TohidBeh/Health-Monitoring-System/Project Description Report/HMS_Report.pdf

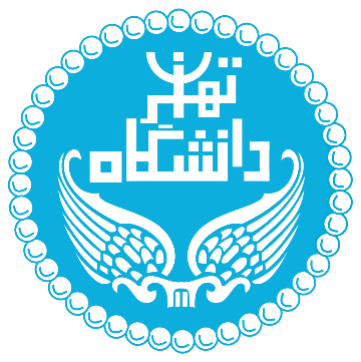
[picture p3: figure]
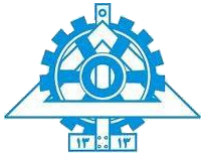
[picture p4: figure]

### به نام خدا

دانشگاه تهران

پردیس دانشکدگان فنی

دانشکده مهندسی برق و کامپیوتر

## ________گزارش پروژه کارشناسی_______

پایاننامه براي دریافت درجه کارشناسی
در رشته مهندسی برق گرایش بایوالکتریک

طراحی و پیادهسازی سامانه پوش یدنی IoT برای مانیتورینگ بالدرنگ عالئم حیاتی و تحلیل هوشمند دادهها

توحید بهشتی__810100100
استاد راهنما : دکتر سیدکمال الدین ستاره دان

نیمسال اول 1405_1404

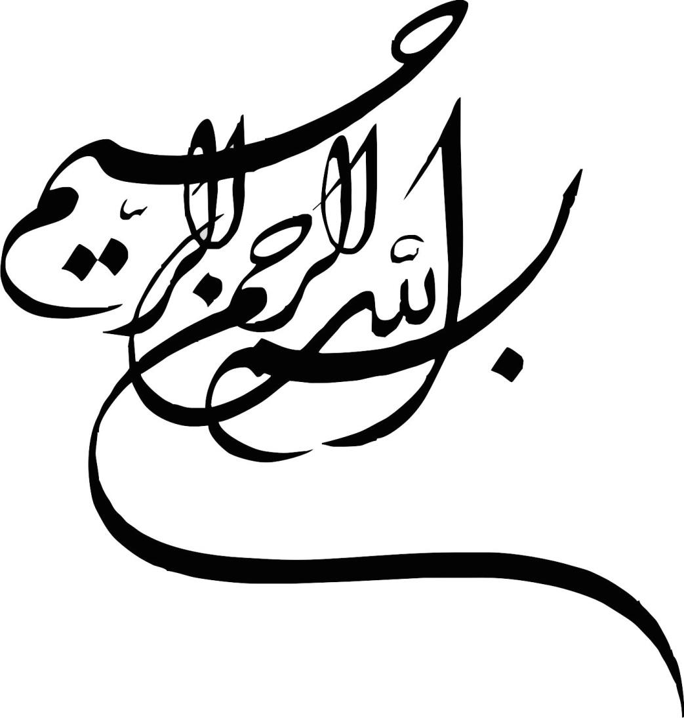
[picture p5: figure]

تعهدنامه اصالت اثر
باسمه تعالی

اینجانب توحید بهشتی تائید می کنم که مطالب مندرج در این پایان نامه حاصل تالش اینجانب است و
به دستاوردهاي پژوهشی دیگران که در این نوشته از آنها استفاده شده است مطابق مقررات ارجاع گردیده است. این پایان نامه قبالٌ براي احراز هیچ مدرك هم سطح یا باالتر ارائه نشده است. کلیه حقوق مادي و معنوي این اثر متعلق به دانشکده فنی دانشگاه تهران می باشد.

نام و نام خانوادگی دانشجو : توحید بهشتی

امضاي دانشجو :

## چکیده

با توجه به افزایش نیاز به پایش مداوم وضعیت سالمت افراد، به ویژه در بیماران قلبی و تنفسی، توسعه سامانههاي هوشمند و کم هزینه براي مانیتورینگ عالئم حیاتی اهمیت زیادي پیدا کرده است. در این پروژه، یک سامانه پایش سالمت ) system monitoring Health )مبتنی بر اینترنت اشیاء)IOT )طراحی و پیادهسازي شد که قادر است برخی از عالئم حیاتی مهم شامل ضربان قلب(BPM (، سطح اکسیژن خون (₂SpO(، دماي بدن و همچنین دماي و رطوبت محیط بیمار را به صورت بالدرنگ اندازهگیري و نمایش دهد .

در این سامانه از میکروکنترلر 32ESP به عنوان هسته اصلی پردازش و ارتباط بی سیم استفاده شده است. سنسور 30100MAX براي اندازهگیري ضربان قلب و میزان اکسیژن خون، سنسور 20B18DS براي دماي بدن و سنسور 11DHT براي اندازه گیري شرایط محیطی)در واقع دما و رطوبت اتاق( به کار گرفته شدند. داده هاي دریافتی پس از پردازش اولیه در میکروکنترلر، از طریق شبکه Fi-Wi در قالب یک وب سرور تعبیه شده (Server Web Embedded (در اختیار کاربر قرار می گیرند و به صورت لحظه اي در یک داشبورد تحت وب قابل مشاهده هست .

در فرآیند پیاده سازي، چالش هاي بسیاري از جمله ناپایداري ارتباطC2I ، خطاي خواندن دماي سنسور 20B18DS و وابستگی عملکرد سنسور 30100MAX به ساختار حلقه اصلی برنامه و مشکالت اختالف نرخ ارسال داده توسط هرکدام از سنسورها, شناسایی و برطرف شد. در نهایت، سامانه توسعه یافته توانست داده هاي حیاتی را با پایداري مناسب دریافت و به صورت برخط نمایش دهد. این پروژه نمونه اي از یک سیستم پایش سالمت کم هزینه و قابل توسعه است که می تواند مبنایی براي گسترش به سامانه هاي ابري، ذخیره سازي بلندمدت داده ها و تحلیل هوشمند عالئم حیاتی در آینده باشد .

کلمات کلیدی : اینترنت اشیاء(IoT (، پایش سالمت، 32ESP، 30100MAX، سیستم غیرمسدودکننده، وبسرور داخلی، تشخیص ناهنجاري

فهرست
چکیده 4 |
فصل اول :مقدمه و بیان مساله7 |

## فصل اول : مقدمه و بیان مساله

-1-1 مقدمه
در دهه هاي اخیر، پیشرفت همزمان فناوري هاي دیجیتال، سیستمهاي نهفته و ارتباطات بیسیم، زمینه را براي به وجود امدن نسل جدید از سامانه هاي هوشمند فراهم کرده است که قادرند داده هاي محیطی و زیستی را به صورت پیوسته جمعآوري، پردازش و منتقل کنند. در این میان، حوزه پایش سالمت مبتنی بر اینترنت اشیا (Monitoring Health Based-IoT (به دلیل ارتباط مستقیم با کیفیت زندگی انسان، از اهمیت ویژه اي برخوردار شده است. افزایش امید به زندگی، شیوع بیماري هاي مزمن قلبی و تنفسی، و نیاز به نظارت مستمر بر وضعیت بیماران، ضرورت توسعه سامانههاي پایش بالدرنگ و کم هزینه را بیش از پیش نمایان ساخته است.

در طول دوران تحصیل در گرایش بایوالکتریک، همواره عالقه مند بودم مفاهیم تئوري و اکادمیک مانند پردازش سیگنالهاي زیستی، طراحی مدارهاي الکتریکی و سیستم هاي نهفته را در قالب یک سیستم واقعی و کاربردي پیاده سازي کنم. به همین دلیل در این پروژه تالش کردم یک سیستم پایش سالمت بر پایه اینترنت اشیا طراحی کنم که هم از نظر سختافزاري و هم از نظر نرم افزاري به صورت کامل توسط خودم توسعه داذ ه شود و در عین حال مقرون به صرفه و قابل توسعه بیشتر باشد .

پایش مستمر عالئم حیاتی نظیر ضربان قلب، سطح اکسیژن خون و دماي بدن، نه تنها در محیط هاي بیمارستانی بلکه در کاربردهاي خانگی و مراقبت از راه دور نیز اهمیت دارد. با این حال، بسیاري از سامانههاي موجود یا داراي هزینه باال هستند یا به زیرساختهاي پیچیده ابري وابستگی کامل دارند. از سوي دیگر، پیاده سازي عملی چنین سیستم هایی با چالشهاي متعددي در سطح سختافزار و نرم افزار همراه است؛ چالش هایی که در بسیاري از مطالعات صرفاً به صورت تئوریک مطرح شده و کمتر در قالب یک تجربه مهندسی کامل مورد بررسی قرار گرفته اند .

پروژه حاضر با هدف طراحی و پیاده سازي یک سامانه پوشیدنی مبتنی بر 32ESP براي پایش بالدرنگ عالئم حیاتی شکل گرفته است؛ سامانه اي که عالوه بر اندازه گیري پارامترهاي زیستی، بر پایداري معماري نرم افزاري، مدیریت زمان بندي سنسورها، حذف نویز و ارائه بازخورد هوشمند در صورت بروز ناهنجاري تمرکز دارد. در این تحقیق تالش شده است که مفاهیم تئوریک سیستم هاي نهفته، پردازش سیگنالهاي زیستی و اینترنت اشیاء در قالب یک سامانه عملی، کم هزینه و قابل توسعه تجمیع شوند .

-1-2تاریخچه ای از موضوع تحقیق

پایش عالئم حیاتی سابقه اي طوالنی در پزشکی دارد. از دستگاههاي الکتروکاردیوگراف (ECG (در دهه هاي ابتدایی قرن بیستم گرفته تا مانیتورهاي چندپارامتري بیمارستانی، همواره هدف، ثبت دقیق سیگنالهاي زیستی براي تشخیص و پایش وضعیت بیمار بوده است. با ورود میکروکنترلرها و سیستم هاي دیجیتال در دهه هاي اخیر، امکان کوچک سازي تجهیزات و انتقال داده ها بهصورت الکترونیکی فراهم شد .

ظهور فناوري اینترنت اشیاء نقطه عطفی در این مسیر محسوب می شود IoT .امکان اتصال اشیاء فیزیکی به شبکه را فراهم می سازد و این قابلیت باعث شد مفهوم ”پایش از راه دور“ از یک ایده تحقیقاتی به یک راهکار عملی تبدیل شود. در بسیاري از مطالعات دانشگاهی، ساختار کلی سیستم شامل یک سنسور زیستی، یک میکروکنترلر مجهز به ماژول ارتباطی و یک پلتفرم ابري براي ذخیره سازي و تحلیل داده ها معرفی شده است.

با وجود پیشرفت هاي چشمگیر، بررسی دقیق تر این حوزه نشان می دهد که تمرکز بسیاري از پروژه ها بر ارسال داده به فضاي ابري بوده و کمتر به چالش هاي عملی نظیر ناپایداري ارتباط C2I ، تأثیر ساختار حلقه برنامه بر کیفیت داده هاي سنسورPPG ، یا تداخل زمانی میان Fi-Wi و نمونه برداري سنسورها پرداخته شده است. همچنین بسیاري از سامانه هاي تجاري موجود اگرچه از نظر عملکرد کامل هستند، اما ساختار آنها بسته بوده و امکان توسعه یا سفارشی سازي محدود دارند .

در این میان، سنسورهاي مبتنی بر فوتوپلتیسموگرافی (PPG (مانند 30100MAX و 30102MAX امکان اندازهگیري ضربان قلب و ₂SpO را در قالب ماژول هاي کوچک و کم هزینه فراهم کرده اند. با این حال، عملکرد این سنسورها به شدت به شرایط تماس، حذف نویز حرکتی و نحوه مدیریت زمانبندي نرم افزار وابسته است. این وابستگی در عمل نشان می دهد که طراحی یک سامانه پایدار تنها با اتصال صحیح قطعات حاصل نمی شود، بلکه نیازمند درك عمیق تعامل میان سختافزار و نرم افزار است.

-1-3شرح مسئله تحقیق
مسئله اصلی این تحقیق، طراحی یک سامانه پایش سالمت کم هزینه و مستقل است که بتواند عالئم حیاتی را به صورت بالدرنگ اندازهگیري و نمایش دهد و در عین حال از نظر معماري نرمافزاري و سختافزاري پایدار باشد .

در مراحل اولیه توسعه، چالشهاي متعددي مشاهده شد. در بخش سخت افزار، سنسور 20B18DS در صورت عدم استفاده از مقاومت up-Pull مقدارهاي غیرواقعی مانند C85° یا C-127° تولید می کرد. همچنین در صورت عدم اجراي تابع مقداردهی اولیه در بخشsetup ، میکروکنترلر قادر به شناسایی سنسور روي باس Wire-One نبود. این موضوع نشان داد که حتی جزئیات کوچک در طراحی می توانند منجر به خطاهاي سیستمی شوند .

در بخش سنسور30100MAX ، مشکل پیچیده تري مشاهده شد. این سنسور براي عملکرد صحیح نیازمند فراخوانی پیوسته تابع update در حلقه اصلی برنامه است. استفاده از توابع مسدودکننده مانند delayیا پردازش سنگین وب سرور باعث توقف اجراي الگوریتم داخلی تشخیص ضربان و در نتیجه تولید خروجی صفر می شد. عالوه بر آن، سیگنالهاي PPG به حرکت دست و نحوه قرارگیري انگشت بسیار حساس بودند و حذف نویز و جهشهاي ناگهانی نیازمند طراحی فیلتر مناسب بود.

از سوي دیگر، اختالف نرخ نمونه برداري سنسورها مسئله مهمی ایجاد می کرد11DHT ،. 20B18DSو 30100MAXهر یک داراي زمان پاسخ و نرخ به روزرسانی متفاوتی هستند. در صورت مدیریت نادرست زمانبندي، خواندن یک سنسور می توانست باعث اختالل در عملکرد دیگري شود. بنابراین مسئله اصلی به این صورت تعریف شد :

چگونه می توان یک سامانه پایش سالمت مبتنی بر 32ESP طراحی کرد که ضمن اندازهگیري پایدار چند پارامتر زیستی، از معماري نرمافزاري غیرمسدودکننده استفاده کند، نسبت به خطاهاي سختافزاري مقاوم باشد و بتواند در صورت بروز ناهنجاري، بازخورد هوشمند ارائه دهد؟

-1-4 تعریف موضوع تحقیق
موضوع این تحقیق، طراحی و پیاده سازي یک سامانه پوشیدنی IoT براي مانیتورینگ بالدرنگ عالئم حیاتی و تحلیل اولیه داده ها است. این سامانه شامل چهار الیه اصلی است: الیه اندازه گیري )سنسورها(،

الیه پردازش ) میکروکنترلر32ESP) ، الیه ارتباطی (server Webو Fi-Wiداخلی ) الیه نمایش )داشبورد تحت وب(

در این پروژه، پارامترهاي زیر اندازه گیري و نمایش داده میشوند :

- ضربان قلب(BPM(
- سطح اکسیژن خون(₂SpO(
- دماي بدن
- دماي محیط
- رطوبت نسبی محیط

عالوه بر نمایش داده ها، براي هر پارامتر بازه هاي فیزیولوژیک تعریف شده و یک سیستم هشدار چندسطحی شامل حالت هايOK ، Warning، Criticalو Fault Sensor پیادهسازي گردیده است. همچنین الگوریتم هاي نرم افزاري براي حذف جهشهاي ناگهانی، فیلتر میانگین نمایی (EMA (و تشخیص برداشتن انگشت از سنسور PPG توسعه داده شدهاند . تمرکز اصلی این تحقیق نه صرفاً ساخت یک مدار، بلکه طراحی یک معماري مهندسی پایدار است که تعامل میان سخت افزار، زمان بندي نرم افزار و نمایش بالدرنگ داده ها را به صورت هماهنگ مدیریت کند .

-1-5اهداف و آرمان های کلی تحقیق

هدف اصلی این تحقیق، طراحی و پیاده سازي یک سامانه پایش سالمت مبتنی بر اینترنت اشیاء است که بتواند چندین پارامتر زیستی و محیطی را به صورت بالدرنگ اندازه گیري، پردازش و نمایش دهد و در عین حال از نظر معماري نرم افزاري و سخت افزاري پایدار و قابل توسعه باشد. این هدف کلی به چند هدف عملیاتی و مهندسی قابل تفکیک است.

نخست، ایجاد یک ساختار ماژوالر که در آن الیه هاي اندازهگیري، پردازش، ارتباط و نمایش تا حد امکان مستقل از یکدیگر طراحی شوند تا افزودن یا جایگزینی سنسورها در آینده نیازمند بازطراحی کامل سیستم نباشد. چنین معمارياي، سامانه را از یک نمونه آزمایشگاهی ساده به یک پلتفرم قابل توسعه تبدیل می کند .

دوم، طراحی یک معماري نرم افزاري غیرمسدودکننده (Blocking-Non (براي مدیریت همزمان چند سنسور با نرخ هاي نمونه برداري متفاوت. یکی از آرمان هاي کلیدي این تحقیق، اثبات این نکته است که در سیستم هاي بالدرنگ، ساختار زمان بندي کد و حذف توابع مسدودکننده نقش تعیینکننده اي در پایداري داده ها دارند .

سوم، افزایش کیفیت سیگنال هاي زیستی از طریق به کارگیري تکنیک هاي پردازش اولیه نظیر حذف جهشهاي ناگهانی(Rejection Spike (، فیلتر میانگین نمایی (EMA (و الگوریتم تشخیص عدم تماس انگشت در سنسور PPG هدف در این بخش، نزدیک شدن رفتار سیستم به یک مانیتور واقعی و جلوگیري از نمایش مقادیر گمراه کننده است.

چهارم، تعریف بازه هاي فیزیولوژیک براي هر پارامتر و پیادهسازي یک سامانه هشدار چندسطحی. در بسیاري از پروژه هاي دانشجویی، داده ها صرفاً نمایش داده می شوند؛ اما در یک سامانه پایش سالمت، ارزش واقعی زمانی ایجاد می شود که سیستم بتواند خروج از محدوده طبیعی را تشخیص داده و بازخورد مناسب ارائه دهد. از این رو، تعریف سطوحOK ، Warning، Criticalو Fault Sensor یکی از اهداف کاربردي این پروژه بوده است .

در نهایت، یکی از آرمان هاي مهم این تحقیق، طراحی سیستمی مستقل از زیرساختهاي ابري است؛ سیستمی که حتی در نبود اینترنت سراسري نیز بتواند در یک شبکه محلی عملکرد کامل داشته باشد. تجربه عملی محدودیت دسترسی به اینترنت در طول اجراي پروژه نشان داد که وابستگی کامل به سرویسهاي خارجی می تواند یک نقطه ضعف جدي در سامانه هاي IoT باشد. بنابراین استقالل عملیاتی، یکی از اصول طراحی این پروژه در نظر گرفته شد .

-1-6 روش انجام تحقیق
روش انجام این تحقیق مبتنی بر رویکرد طراحی و پیاده سازي مهندسی بوده است. فرآیند توسعه در چند مرحله متوالی و تکرارشونده انجام شد که شامل مطالعه، طراحی اولیه، پیاده سازي، آزمون، عیب یابی و بهینه سازي بوده است.

در مرحله نخست، مطالعه منابع مرتبط با سامانه هاي پایش سالمت مبتنی بر IoT و بررسی دیتاشیت سنسورها و میکروکنترلر انجام شد. در این مرحله، معیارهایی نظیر هزینه، در دسترس بودن، دقت اندازهگیري و سازگاري ارتباطی براي انتخاب ماژول ها در نظر گرفته شد. نتیجه این بررسیها انتخاب

32ESPبه عنوان هسته پردازشی و سنسورهاي30100MAX ، 20B18DSو 11DHT به عنوان منابع داده بود.

در مرحله دوم، طراحی سخت افزار و پیاده سازي اتصاالت انجام شد. در این مرحله، چالشهاي عملی نظیر نیاز به مقاومت up-Pull در پروتکلWire-One ، طول سیمهاي C2I و کیفیت تغذیه مورد بررسی قرار گرفت. خطاهاي مشاهده شده، به صورت مرحله اي تحلیل و اصالح شدند تا یک ساختار سختافزاري پایدار حاصل شود.

مرحله سوم به توسعه نرم افزار اختصاص یافت. در ابتدا ساختارهاي ساده مبتنی بر delay مورد آزمایش قرار گرفت، اما به دلیل بروز اختالل در خواندن سنسور30100MAX ، معماري برنامه به صورت کامل بازطراحی شد. استفاده از تابع millis براي مدیریت زمان، جداسازي وظایف هر سنسور و اجراي پیوسته تابع update در حلقه اصلی، هسته معماري نهایی را شکل داد.

در ادامه، براي بهبود کیفیت داده ها، الگوریتم هاي نرم افزاري پردازش اولیه پیاده سازي شدند. حذف جهشهاي ناگهانی، میانگینگیري نمایی و مکانیزم تشخیص عدم حضور انگشت از طریق تحلیل فاصله زمانی بین ضربان ها (Timeout Beat (بخشی از این فرآیند بود. سپس سیستم هشدار چندسطحی طراحی و در داشبورد تحت وب یکپارچه شد .

در مرحله نهایی، سیستم در سناریوهاي مختلف شامل حالت استراحت، پس از فعالیت بدنی سبک، قطع تماس سنسور و کار مداوم چندساعته مورد آزمون قرار گرفت. داده هاي مشاهدهشده با مقادیر فیزیولوژیک مرجع مقایسه و پایداري عملکرد ارزیابی شد. این رویکرد تکرارشونده آزمون و اصالح، نقش کلیدي در رسیدن به نسخه نهایی سامانه ایفا کرد.

-1-7 ساختار پایان نامه
این پایاننامه در پنج فصل تدوین شده است.

در فصل اول، مقدمه، پیشینه موضوع، تعریف مسئله، اهداف تحقیق و روش انجام آن ارائه شد تا چارچوب کلی پژوهش مشخص شود.

فصل دوم به بررسی مفاهیم نظري و مبانی فنی مرتبط با پروژه اختصاص دارد. در این فصل، اصول اینترنت اشیاء، ساختار سیستمهاي نهفته، مبانی سنسورهاي مبتنی برPPG ، پروتکل هاي ارتباطی مانند C2Iو Wire-One و اصول طراحی نرم افزار غیرمسدودکننده مورد بررسی قرار می گیرد .

فصل سوم به طراحی سختافزار و معماري کلی سیستم میپردازد. در این فصل، انتخاب میکروکنترلر و سنسورها، نحوه اتصال ماژول ها، مالحظات تغذیه و چالش هاي عملی پیاده سازي تشریح می شود.

فصل چهارم شامل طراحی نرمافزار، پیاده سازي الگوریتم ها، مدیریت زمان بندي، توسعه وبسرور داخلی و سیستم هشدار است. همچنین نتایج آزمون هاي عملی و ارزیابی عملکرد سامانه در این فصل ارائه می شود.

در فصل پنجم، جمع بندي کلی پروژه، دستاوردهاي مهندسی، محدودیت ها و پیشنهادهاي توسعه آینده مطرح می گردد.

این ساختار به گونه اي تنظیم شده است که خواننده ابتدا با مسئله و ضرورت آن آشنا شود، سپس با مبانی نظري و طراحی فنی مواجه گردد و در نهایت نتایج عملی و تحلیل عملکرد سامانه را مشاهده کند. چنین ترتیبی، مسیر منطقی شکلگیري ایده تا تحقق عملی آن را به صورت شفاف نمایش می دهد .

## فصل دوم: مفاهیم اولیه و پیش زمینه

-1-1اینترنت اشیاء و سامانههای پایش سالمت
اینترنت اشیاء (IoT - Things of Internet (به شبکه اي از اشیاي فیزیکی اطالق می شود که از طریق حسگرها، ماژول هاي پردازشی و بسترهاي ارتباطی قادر به جمع آوري، تبادل و تحلیل داده هستند بطوري که ویژگی هاي اصلی سیستم معرفی شده را دارا باشند.

در حوزه سالمت، IoTزمینه ساز شکلگیري مفهوم پایش سالمت از راه دور Health Remote( (monitoringشده است. در این رویکرد، داده هاي حیاتی بیمار بدون نیاز به حضور دائمی در مراکز درمانی ثبت و منتقل می شوند. چنین سامانه هایی معموالً شامل سه الیه اصلی هستند: الیه حسگرها

(Layer Sensing(، الیه پردازش و کنترل (Layer Processing (و الیه ارتباط و نمایش ) User

.)Interface

در سامانه هاي پزشکی، پایداري و دقت اهمیت ویژه اي دارند. برخالف بسیاري از کاربردهاي عمومیIoT ، در پایش سالمت هرگونه خطاي اندازه گیري می تواند منجر به تفسیر اشتباه وضعیت بیمار شود. بنابراین عالوه بر سخت افزار مناسب، طراحی نرم افزار پایدار و مدیریت زمان بندي از اهمیت اساسی برخوردار است.

یکی از چالش هاي مهم در سامانه هاي IoT پزشکی، وابستگی به زیرساختهاي ابري است. اگرچه استفاده ازPlatform Cloud ها امکان ذخیره سازي و تحلیل بلندمدت داده ها را فراهم می کند، اما در بسیاري از شرایط عملی ( به ویژه در شبکههاي محلی یا هنگام قطعی اینترنت ) وابستگی کامل به فضاي ابري می تواند عملکرد سیستم را مختل کند . به همین دلیل، معماريهاي مبتنی بر Server Web داخلی که پردازش و نمایش را در همان گره محلی انجام می دهند، رویکردي پایدارتر و مستقل تر محسوب می شوند .

در پروژه حاضر، سامانه طراحیشده در همین چارچوب تعریف می شود؛ به طوري که 32ESP عالوه بر نقش پردازشی، وظیفه ایجاد یک Server Web Embedded را نیز بر عهده دارد .

انتخاب میکروکنترلر

در مرحله انتخاب یونیت پردازشی ، گزینه هایی مثل 32STM ، Pico Pi Raspberryو 32ESP مورد بررسی قرار گرفتند. با تحقیق هایی که انجام دادم و مقایسه امکانات، مشخص شد که 32ESP ترکیبی مناسب از توان پردازش باال ، ارتباط fi_Wi داخلی و هزینه پایین را ارائه می دهد .

بر اساس Manual شرکت Espressif ، این میکروکنترلر داراي پردازنده دو هسته اي، پشتیبانی از fi_Wi و Bluetooth و همچنین رابط هاي ارتباطی متنوعی مانند C2I و SPIو UART هست. مهم ترین مزیت آن براي این پروژه وجود fi_Wi داخلی بود که نیاز به ماژول جداگانه fi_Wi را حذف می کرد و پیچیدگی مدار را کاهش می داد.

همچنین در پباده سازي عملی مشخص شد که 32ESP توانایی مدیریت هم زمان خواندن سنسورهاي C2I و راه اندازي یک وب سرور داخلی را دارد، البته به شرط آنکه ساختار برنامه به درستی زمان بندي شود.

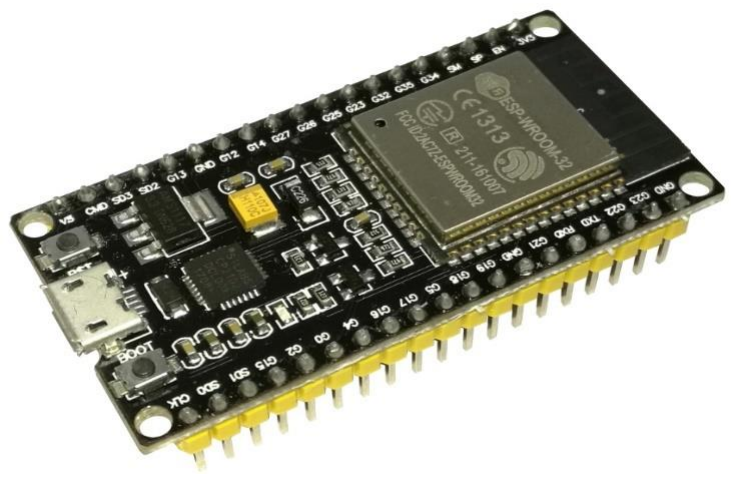
[picture p6: figure]

ESP3_ MCU .1شکل

-2-2مبانی سنجش عالئم حیاتی و سنسورهای مورد استفاده فوتوپلتیسموگرافی (PPG (و اندازه گیری BPM و₂SpO

سنسور 30100MAX بر پایه تکنیک فوتوپلتیسموگرافی (PPG – Photoplethysmography (عمل می کند. در این روش، با تابش نور قرمز و مادون قرمز به بافت و اندازه گیري نور بازتابشده، تغییرات حجم خون در مویرگ ها تشخیص داده می شود. این تغییرات به صورت یک سیگنال نوسانی ظاهر می شوند

براي محاسبه ضربان قلب(BPM (، فاصله زمانی بین قله هاي متوالی سیگنال PPG اندازهگیري می شود. در محاسبه₂SpO ، نسبت جذب نور در دو طول موج مختلف مورد استفاده قرار می گیرد، زیرا هموگلوبین اکسیژن دار و بدون اکسیژن ضرایب جذب متفاوتی دارند .

با وجود سادگی ظاهري، سیگنال PPG بسیار حساس به حرکت(Artifact Motion (، فشار تماس انگشت و نور محیط است. بنابراین پردازش نرم افزاري و زمان بندي صحیح نمونه برداري نقش حیاتی در کیفیت خروجی دارد. در صورت اختالل در اجراي مداوم الگوریتم داخلی سنسور، خروجی ممکن است به صفر میل کند یا مقادیر غیرواقعی تولید شود.

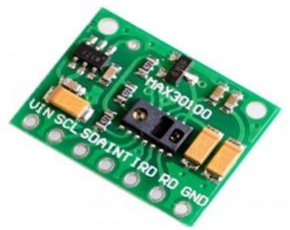
[picture p7: figure]

MAX30100 (BPM & SpO2 Sensor) .2شکل

سنجش دمای بدن با20B18DS

سنسور 20B18DS یک سنسور دیجیتال مبتنی بر پروتکل Wire-One است که امکان اندازه گیري دما با دقت مناسب را فراهم می کند. خروجی دیجیتال این سنسور باعث کاهش تأثیر نویز آنالوگ می شود. با این حال، پروتکل Wire-One نیازمند وجود مقاومت up-Pull روي خط داده است و در صورت عدم رعایت این موضوع، مقادیر خطا مانند C85° یا C-127° گزارش می شود.

همچنین این سنسور براي عملکرد صحیح نیازمند مقداردهی اولیه در بخش setup برنامه است. عدم اجراي تابع begin initial منجر به عدم شناسایی دستگاه روي باس و تولید مقدار پیش فرض خطا می شود. این نکته نشان می دهد که تعامل صحیح میان الیه سخت افزار و نرم افزار براي دستیابی به داده معتبر ضروري است.

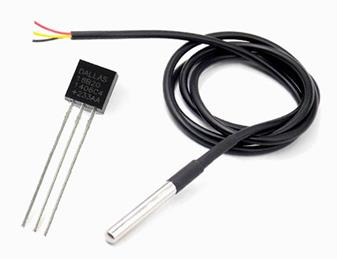
[picture p8: figure]

DS18B20 (Body Temperature Sensor) .3شکل

سنجش شرایط محیطی با11DHT

سنسور 11DHT براي اندازهگیري دماي محیط و رطوبت نسبی استفاده می شود. این سنسور داراي دقت قابل قبول براي کاربردهاي عمومی بوده و از طریق یک پروتکل تک سیمه با میکروکنترلر ارتباط برقرار می کند. داده هاي محیطی عالوه بر تکمیل تصویر فیزیولوژیک فرد، می توانند در تحلیل تغییرات عالئم حیاتی نیز مؤثر باشند؛ زیرا شرایط محیطی بر عملکرد سیستم تنفسی و قلبی تأثیرگذار است.

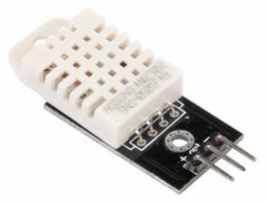
[picture p9: figure]

DHT11 (Room Humidity and Temperatue) .4شکل

-2-3معماری نرم افزارهای بالدرنگ و برنامهنویسی غیرمسدودکننده

در سیستم هاي نهفته چندوظیفه اي، ساختار برنامه نویسی نقش تعیین کنندهاي در پایداري سیستم دارد. استفاده از توابع مسدودکننده مانند delay باعث توقف اجراي سایر بخش هاي برنامه می شود و در سامانههایی که نیازمند نمونه برداري مداوم هستند، این امر می تواند منجر به از دست رفتن داده یا اختالل در الگوریتم هاي داخلی شود.

در میکروکنترلري مانند 32ESP که به طور هم زمان وظیفه مدیریتFi-Wi ، اجراي Server Web و خواندن سنسورها را بر عهده دارد، استفاده از معماري غیرمسدودکننده Blocking-Non( (Architectureیک ضرورت محسوب می شود. در این رویکرد، به جاي توقف برنامه براي مدت مشخص، از تابع ()millis براي مدیریت زمان استفاده می شود و هر وظیفه در بازه هاي زمانی تعیین شده اجرا می گردد.

این ساختار امکان اجراي هم زمان چند سنسور با نرخ هاي نمونه برداري متفاوت را فراهم می کند. براي مثال، سنسور 30100MAX نیازمند اجراي پیوسته تابع update در حلقه اصلی است، در حالی که 20B18DSو 11DHT داراي زمان پاسخ طوالنی تر هستند و می توانند در بازه هاي زمانی بزرگ تر خوانده شوند .

معماري غیرمسدودکننده همچنین بستر مناسبی براي پیاده سازي الگوریتم هاي پردازش سیگنال و سیستم هشدار فراهم می کند. در چنین ساختاري، می توان بدون اختالل در خواندن سنسورها، مقادیر را فیلتر کرده، بازه هاي ناهنجاري را بررسی نمود و وضعیت کلی سیستم را به روزرسانی کرد.

در پروژه حاضر، بازطراحی حلقه اصلی برنامه و حذف کامل delay هاي طوالنی، نقطه عطفی در رسیدن به عملکرد پایدار سیستم بود. این تجربه نشان داد که در سیستمهاي بالدرنگ، کیفیت معماري نرم افزار به اندازه انتخاب سنسور اهمیت دارد.

## فصل سوم: طراحی و پیاده سازی سیستم

-3-1مقدمه
پس از بررسی مبانی نظري و پیشزمینه علمی در فصل قبل، در این فصل فرآیند طراحی و پیاده سازي عملی سامانه پایش سالمت ارائه می شود. هدف این فصل، تشریح دقیق تصمیم هاي مهندسی اتخاذشده در مسیر توسعه سیستم و تحلیل چالش هاي عملی است که در فرآیند پیاده سازي بروز کرده اند .

در طراحی یک سامانه IoT پزشکی، صرف اتصال چند سنسور به یک میکروکنترلر کافی نیست. کیفیت عملکرد نهایی وابسته به هماهنگی میان الیه هاي مختلف سیستم، مدیریت منابع پردازشی، کنترل نویز، زمانبندي دقیق نرم افزار و ارائه خروجی قابل اعتماد است. از این رو، در این فصل ابتدا معماري کلی سیستم معرفی شده و سپس طراحی سختافزار و نرم افزار به صورت مرحله اي تشریح میشود.

-3-2معماری کلی سیستم و مدل الیهای
سامانه طراحیشده بر اساس یک مدل الیه اي چهارسطحی توسعه یافته است. این مدل با هدف افزایش ماژوالر بودن، کاهش وابستگی بین بخش ها و تسهیل عیبیابی انتخاب شده است.

الیه اندازه گیری(Layer Sensing(

در این الیه، سنسورهاي زیستی و محیطی قرار دارند که وظیفه جمع آوري داده هاي خام را بر عهده دارند. در این پروژه :

- 30100MAXبراي اندازه گیري BPM و₂SpO
- 20B18DSبراي دماي بدن
- 11DHTبراي دما و رطوبت محیط

هر سنسور داراي نرخ نمونه برداري، پروتکل ارتباطی و محدودیت هاي عملیاتی متفاوتی است. این ناهمگونی یکی از چالش هاي اصلی طراحی سیستم بوده است.

الیه پردازش(Layer Processing(

این الیه توسط میکروکنترلر 32ESP پیاده سازي شده است. وظایف این الیه شامل: خواندن داده ها از سنسورها ,مدیریت زمان بندي, اعمال فیلترهاي نرم افزاري, تشخیص شرایط ناهنجار, تولید داده هاي نهایی براي نمایش

انتخاب 32ESP به دلیل وجود Fi-Wi داخلی، توان پردازشی مناسب و پشتیبانی از پروتکلهاي ارتباطی مختلف صورت گرفته است.

الیه ارتباطی(Layer Communication(

در این پروژه از Fi-Wi داخلی 32ESP براي راه اندازي یک Server Web داخلی استفاده شده است. در این معماري، دستگاه پس از اتصال به شبکه محلی یک IP دریافت می کند و کاربر می تواند با وارد کردن آن در مرورگر، داشبورد را مشاهده کند .

این طراحی باعث شده سیستم وابسته به Cloud نباشد و حتی در شرایط قطعی اینترنت سراسري نیز عملکرد کامل داشته باشد .

(User Interface Layer) | نمایش | الیه

داشبورد تحت وب طراحی شده شامل نمایش بالدرنگ پنج پارامتر اصلی و یک سیستم هشدار چندسطحی است. تولید صفحه HTML به صورت پویا توسط تابع SendHTML انجام میشود و داده ها هر یک ثانیه به روزرسانی می شوند . معماري الیه اي انتخاب شده باعث شده تغییر در یک بخش )مثالً جایگزینی سنسور( کمترین تأثیر را بر سایر بخشها داشته باشد .

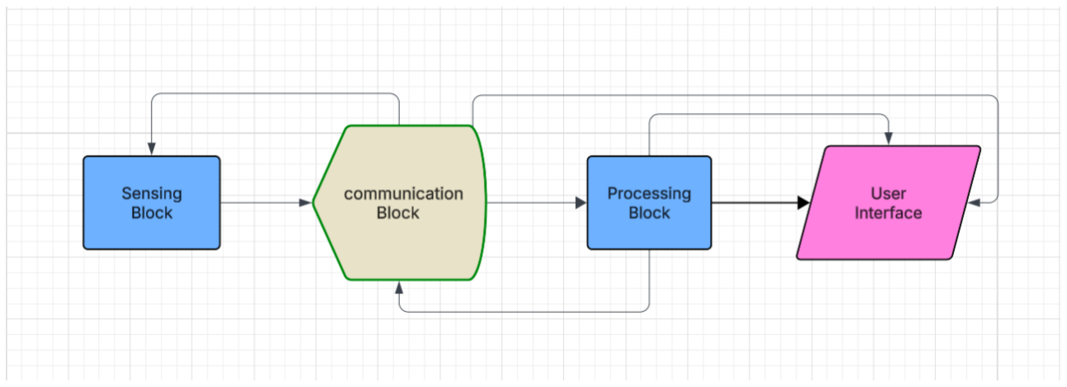
[picture p10: figure]
-3-3 طراحی سختافزار و پیادهسازی فیزیکی; انتخاب میکروکنترلر

شکل.5 بلوك دیاگرام نحوه ارتباط بلوك هاي اصلی

در مرحله انتخاب واحد پردازشی، گزینه هایی مانند 32STM ، Pico Pi Raspberryو 32ESP مورد بررسی قرار گرفتند. معیارهاي انتخاب شامل :توان پردازشی کافی, وجود Fi-Wi داخلی, مصرف توان مناسب, در دسترس بودن کتابخانهها, هزینه پایین 32ESP با داشتن پردازنده دو هسته اي، ماژول-Wi Fiداخلی و پشتیبانی از C2I وWire-One ، گزینه اي مناسب براي این پروژه تشخیص داده شد .

طراحی اتصاالت و پروتکل ها

اتصال 30100MAX از طریق پروتکل C2I انجام شد. در تستهاي اولیه، طول زیاد سیمها و کیفیت تغذیه باعث بروز ناپایداري در ارتباط شد. با کوتاه کردن سیمها و بهبود اتصاالت، این مشکل برطرف گردید .

سنسور 20B18DS از پروتکل Wire-One استفاده می کند. بر اساس دیتاشیت، وجود مقاومت up-Pull به مقدار k4.7 بین خط داده و VCC ضروري است. در مراحل اولیه، عدم استفاده از این مقاومت باعث تولید مقادیر C85° و C-127° شد. پس از افزودن مقاومت، پایداري داده ها به طور کامل بهبود یافت.

سنسور 11DHT نیز از یک خط داده تک سیمه استفاده میکند و نیازمند رعایت زمان بندي دقیق در خواندن داده است.

مالحظات عملی

در فرآیند پیاده سازي مشخص شد که عوامل زیر تأثیر قابل توجهی بر کیفیت داده ها دارند :

- کیفیت منبع تغذیه
- طول سیم هاي ارتباطی
- تماس صحیح انگشت با سنسورPPG
- نویز محیطی

این موارد نشان دادند که طراحی سختافزار تنها محدود به شماتیک نیست، بلکه شرایط واقعی بهرهبرداري نیز باید در نظر گرفته شوند .

-3-4طراحی نرمافزار و معماری غیرمسدودکننده
برنامه شامل سه بخش اصلیsetup ، loopو توابع ماژوالر براي هر سنسور است. در تابع setup عملیات مقداردهی اولیه سنسورها، اتصال Fi-Wi و راه اندازي Server Web انجام میشود.

در مراحل اولیه، از ساختارهاي مبتنی بر delay استفاده شد. اما این روش باعث اختالل در عملکرد 30100MAXمیشد، زیرا کتابخانه این سنسور نیازمند اجراي مداوم تابع update در حلقه اصلی است.

بازطراحی معماری

براي رفع این مشکل، معماري برنامه به صورت کامل به ساختار غیرمسدودکننده تبدیل شد. در این ساختار:

- هیچ delay طوالنی وجود ندارد
- از millis براي مدیریت زمان استفاده می شود
- هر سنسور در بازه زمانی مناسب خود خوانده می شود
- تابع update سنسور PPG به صورت پیوسته اجرا می شود

این تغییر باعث حذف کامل مشکل صفر شدن BPM و ₂SpO در هنگام اجراي هم زمان وبسرور شد .

مدیریت اختالف نرخ نمونهبرداری

یکی از چالش هاي اصلی، اختالف زمان پاسخ سنسورها بود 30100MAX نیازمند نمونه برداري پیوسته است، در حالی که 20B18DS و 11DHT داراي تأخیر ذاتی در پاسخ هستند. با تفکیک زمان بندي هر سنسور، این تضاد حل شد .

این تجربه نشان داد که طراحی نرم افزار در سیستم هاي بالدرنگ به اندازه انتخاب سخت افزار اهمیت دارد.

-3-5 طراحی الگوریتمهای پردازش سیگنال و سیستم هشدار
یکی از مهم ترین بخش هاي طراحی سامانه، تبدیل داده هاي خام سنسورها به اطالعات قابل اعتماد و قابل تفسیر است. به ویژه در مورد سیگنالهاي مبتنی برPPG ، داده هاي خروجی مستعد نویز حرکتی، تغییرات ناگهانی و خطاهاي ناشی از تماس نامناسب هستند. بنابراین پردازش نرم افزاري نه به عنوان یک قابلیت اضافی، بلکه به عنوان بخشی ضروري از معماري سیستم در نظر گرفته شد .

در مرحله نخست، براي کاهش نوسانات ناگهانی در مقادیر BPM و₂SpO ، مکانیزم حذف جهش Spike( (Rejectionپیادهسازي شد. در این روش، اگر اختالف مقدار فعلی با مقدار قبلی از یک آستانه مشخص فراتر می رفت و از نظر فیزیولوژیک قابل توجیه نبود، مقدار جدید بهعنوان خطاي احتمالی در نظر گرفته می شد و وارد فرآیند فیلتر نمیگردید. این کار از نمایش مقادیر غیرواقعی ناشی از حرکت دست جلوگیري کرد.

در گام بعدي، براي هموارسازي سیگنال از فیلتر میانگین نمایی – Average Moving Exponential( (EMAاستفاده شد. این فیلتر با وزن دهی بیشتر به داده هاي اخیر و حفظ روند کلی تغییرات، نوسانات لحظه اي را کاهش داد بدون آنکه پاسخ دینامیکی سیستم بیش از حد کند شود. انتخاب ضریب هموارسازي بر اساس آزمون عملی انجام شد تا تعادلی میان پایداري و سرعت پاسخ برقرار گردد.

با وجود این بهبودها، در شرایطی که کاربر انگشت خود را از روي سنسور 30100MAX برمی داشت، مقادیر قبلی براي چند ثانیه ثابت باقی می ماندند و سیستم همچنان آن ها را معتبر تلقی می کرد. این رفتار از دیدگاه پایش سالمت قابل قبول نبود. براي رفع این مسئله، الگوریتم تشخیص عدم تماس بر اساس فاصله زمانی بین ضربانهاي تشخیص داده شده طراحی شد. اگر در بازه زمانی مشخصی هیچ Beat جدیدي ثبت نمی شد، سیستم نتیجه می گرفت که تماس قطع شده است و مقادیر BPM و ₂SpO را به صفر یا وضعیت Fault Sensor منتقل می کرد. این اصالح باعث شد رفتار سیستم در شرایط واقعی بسیار طبیعیتر و قابل اعتمادتر شود.

در کنار پردازش سیگنال، طراحی سیستم هشدار چندسطحی نیز انجام شد. براي هر پارامتر، بازه هاي فیزیولوژیک تعریف گردید و وضعیت آن در یکی از چهار سطحOK ، Warning، Criticalیا Sensor Faultطبقه بندي شد. به منظور جلوگیري از هشدارهاي کاذب، تغییر وضعیت تنها در صورتی اعمال می شد که مقدار خارج از محدوده براي چند نمونه متوالی تکرار گردد. این مکانیزم نوعی تأخیر منطقی ایجاد می کند که مانع از واکنش به نوسانات گذرا می شود.

وضعیت نهایی هر پارامتر در یک سطح کلی سیستم تجمیع می شود و داشبورد بر اساس شدیدترین وضعیت فعال، رنگ و پیام مناسب را نمایش می دهد. این طراحی باعث شد سامانه از یک نمایشگر ساده داده به یک مانیتور فعال و واکنش گرا تبدیل شود.

-3-6ابزارهای توسعه و محیط پیادهسازی
توسعه نرم افزار با استفاده از محیط IDE Arduino انجام شد که به دلیل وجود کتابخانه هاي آماده براي 32ESPو سنسورهاي مورد استفاده، فرآیند پیاده سازي را تسهیل می کند. کتابخانه

PulseOximeter_30100MAXبراي مدیریت الگوریتم داخلیPPG ، کتابخانه DallasTemperature
براي 20B18DS و کتابخانه DHT براي سنسور محیطی مورد استفاده قرار گرفتند .

در فرآیند توسعه، استفاده از Monitor Serial نقش مهمی در عیبیابی ایفا کرد. بسیاري از خطاهاي اولیه، از جمله مقدار -127 در سنسور دماي بدن یا صفر شدنBPM ، از طریق بررسی خروجی سریال و تحلیل مرحله اي کد شناسایی شدند. این رویکرد سیستماتیک در دیباگ باعث شد علت ریشه اي مشکالت مشخص شود، نه اینکه صرفاً با تغییرات تصادفی در کد برطرف گردند .

طراحی رابط کاربري تحت وب به صورت تولید رشته HTML در سمت سرور انجام شد. در مراحل اولیه، استفاده نادرست از کوتیشن هاي تو در تو در بخش JavaScript منجر به خطاهاي کامپایل می شد. با بازطراحی ساختار رشتهها و استفاده صحیح از کاراکترهاي escape ، این مشکل برطرف شد. طراحی CSSساده ولی هدفمند باعث شد داشبورد عالوه بر عملکرد مناسب، از نظر بصري نیز ساختار منسجم و حرفه اي داشته باشد .

-3-7 معیارهای ارزیابی طراحی
براي ارزیابی عملکرد سامانه، چند معیار کلیدي در نظر گرفته شد. نخستین معیار، پایداري در خواندن داده ها طی زمان طوالنی بود. سیستم در بازه هاي چندساعته مورد آزمون قرار گرفت تا مشخص شود آیا اجراي هم زمان وب سرور و سنسورها باعث افت عملکرد میشود یا خیر.

معیار دوم، صحت نسبی مقادیر اندازه گیري شده بود. مقادیر ضربان قلب و سطح اکسیژن خون در شرایط استراحت و پس از فعالیت سبک ثبت و با بازه هاي فیزیولوژیک مرجع مقایسه شدند. همچنین دماي محیط با یک دماسنج مرجع مقایسه گردید تا انحراف احتمالی مشخص شود.

معیار سوم، رفتار سیستم در شرایط خطا بود. قطع سنسور دماي بدن، برداشتن انگشت از سنسور PPG و ایجاد نویز حرکتی از جمله سناریوهایی بودند که براي بررسی واکنش سیستم اجرا شدند. هدف این بود که سامانه نه تنها در شرایط ایدهآل، بلکه در شرایط غیرعادي نیز رفتار قابل پیش بینی داشته باشد .

معیار چهارم، پاسخگویی رابط کاربري و به روزرسانی بالدرنگ داشبورد بود. بررسی شد که آیا تأخیر شبکه یا پردازش داخلی باعث کندي نمایش می شود یا خیر.

-3-8تحلیل طراحی و جمعبندی
تحلیل نهایی طراحی نشان میدهد که موفقیت سامانه بیش از آنکه وابسته به انتخاب سنسورها باشد، نتیجه طراحی صحیح معماري نرم افزار و مدیریت منابع پردازشی است. حذف ساختارهاي مسدودکننده و استفاده از زمان بندي مبتنی بر millis نقطه عطف اصلی در رسیدن به عملکرد پایدار بود. همچنین تجربه خطاهاي سختافزاري نظیر نبود مقاومت up-Pull یا مقداردهی اولیه نادرست نشان داد که در سیستمهاي نهفته، کوچک ترین جزئیات می توانند اثر قابل توجهی بر خروجی داشته باشند .

در مجموع، طراحی انجام شده نشان می دهد که ترکیب معماري ماژوالر، برنامه نویسی غیرمسدودکننده، پردازش اولیه سیگنال و طراحی مناسب رابط کاربري می تواند منجر به ایجاد یک سامانه پایش سالمت کم هزینه ولی پایدار شود. تجربه عملی این پروژه بیانگر آن است که فرآیند آزمون، خطا و بهینه سازي تدریجی بخش جدایی ناپذیر طراحی مهندسی است و رسیدن به نسخه نهایی نتیجه اصالحات مرحله اي و تحلیل دقیق مشکالت بوده است.

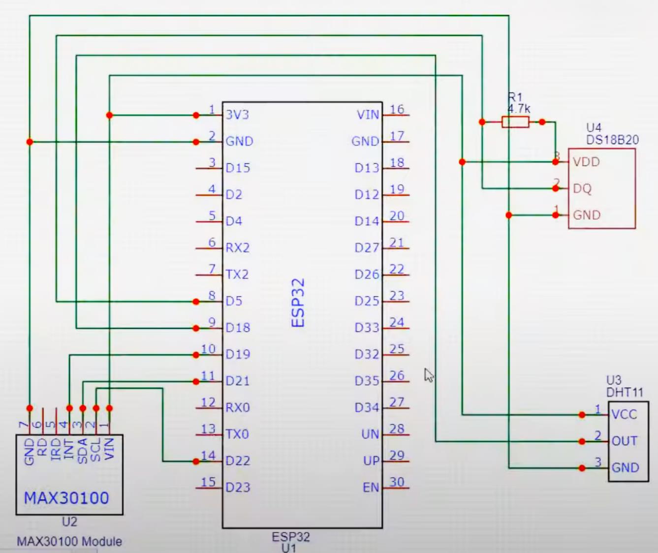
[picture p11: figure]

شکل.6 شماتیک سیستم و اتصاالت برقرار شده بین ماژول ها

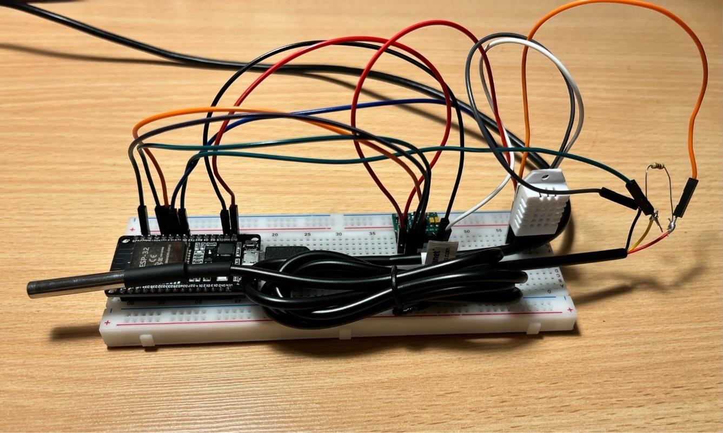
[picture p12: figure]

شکل.7 شکل نهایی سیستم پیاده سازي شده برروي بردبورد

## فصل چهارم: پیاده سازی سامانه

-4-1مقدمه
پس از طراحی معماري سختافزار و نرم افزار در فصل سوم، مرحله پیاده سازي عملی سامانه آغاز شد. هدف این مرحله، تحقق فیزیکی طراحی انجام شده و ارزیابی رفتار واقعی سیستم در شرایط مختلف بود. در این فرآیند، مشخص شد که بسیاري از چالش هاي سیستمهاي نهفته تنها در مرحله اجرا و آزمون عملی آشکار می شوند و مستقیماً قابل پیش بینی از روي طراحی نظري نیستند .

پیادهسازي این سامانه نه تنها شامل اتصال ماژول ها و نوشتن کد، بلکه شامل فرآیند آزمون، خطا، تحلیل علت ریشه اي مشکالت و بازطراحی بخش هایی از نرم افزار بود. به همین دلیل، این فصل عالوه بر شرح اجراي سیستم، نشان دهنده مسیر تکامل آن از یک نمونه اولیه ناپایدار به نسخه اي پایدار و قابل اتکا است.

-4-2 پیادهسازی سختافزار و یکپارچهسازی ماژول ها
در مرحله نخست، کلیه ماژولها شامل32ESP ، 30100MAX، 20B18DSو 11DHT مطابق شماتیک طراحیشده به یکدیگر متصل شدند. تغذیه سیستم از طریق پورت USB تأمین گردید و ولتاژ 3.3 ولت مورد نیاز سنسورها از خروجی رگوالتور داخلی برد 32ESP تأمین شد .

اتصال30100MAX

این سنسور از طریق پروتکل C2I به 32ESP متصل شد. پایه هاي SDA و SCL به پایه هاي تعریف شده در کد متصل شدند و زمین و تغذیه به صورت مشترك با سایر اجزا برقرار گردید. در تستهاي اولیه، مشاهده شد که افزایش طول سیم ها و عبور آن ها از نزدیکی خطوط تغذیه باعث ایجاد نویز و ناپایداري در داده هاي BPM می شود. با کوتاهسازي مسیرها و بهبود آرایش سیم کشی، این مشکل به طور کامل برطرف شد .
همچنین کیفیت تماس انگشت با سنسور تأثیر مستقیم بر شکل سیگنال PPG داشت. فشار بیش از حد یا تماس ناکافی منجر به نوسانات غیرعادي در مقادیر می شد. این مشاهده اهمیت تعامل کاربر با سامانه را نیز نشان داد.

DS18B20 اتصال

این سنسور از طریق پروتکل Wire-One به 32ESP متصل شد. مقاومت up-Pull با مقدار 4.7 kΩبین خط داده و 3.3 ولت قرار گرفت. در مراحل اولیه، عدم استفاده از این مقاومت باعث بازگشت مقادیر خطا مانند C-127° میشد. پس از افزودن مقاومت و اطمینان از لحیم صحیح اتصاالت، خواندن داده ها پایدار شد .

همچنین اجراي صحیح تابع مقداردهی اولیه در بخش setup نقش اساسی در شناسایی سنسور روي باس داشت. بدون این مرحله، میکروکنترلر هیچ دستگاهی را شناسایی نمیکرد.

اتصال11DHT

سنسور 11DHT به یکی از پایه هاي دیجیتال 32ESP متصل شد. این سنسور به دلیل ماهیت تک سیمه خود نیازمند رعایت دقیق زمانبندي در سطح نرم افزار است. در برخی تستهاي اولیه، خواندن سریع تر از حد مجاز باعث دریافت داده هاي نامعتبر می شد. با تنظیم بازه زمانی مناسب بین خواندنها، این مشکل رفع گردید .

مالحظات عملی

در حین پیاده سازي مشخص شد که موارد زیر تأثیر قابل توجهی بر عملکرد دارند :

- اشتراك صحیح زمین بین تمامی ماژول ها
- جلوگیري از عبور خطوط C2I از کنار خطوط تغذیه
- تثبیت مکان فیزیکی سنسور PPG هنگام تست
- جلوگیري از تغییر ناگهانی بار منبع تغذیه

این موارد گرچه در طراحی شماتیک ساده به نظر می رسند، اما در عمل تعیین کننده کیفیت عملکرد نهایی بودند .

-4-3پیادهسازی نرمافزار و ساختار اجرایی نهایی ساختار اصلی برنامه

نسخه نهایی برنامه شامل سه بخش اصلیsetup ، loopو مجموعه اي از توابع ماژوالر براي هر سنسور است. در تابع setup عملیات زیر انجام می شود:

- مقداردهی اولیه ارتباط سریال براي دیباگ
DS18B20 | براي sensors.begin | اجراي | •
- راهاندازي سنسور 30100MAX و تعیین نرخ نمونه برداري
- اتصال به شبکهFi-Wi
- راهاندازي Server Web داخلی

ترتیب اجراي این مراحل اهمیت زیادي داشت. در تستهاي اولیه مشخص شد که در برخی شرایط، اتصال Fi-Wi پیش از مقداردهی کامل سنسورها باعث تأخیر در راه اندازي C2I میشود. با تغییر ترتیب مراحل، این مشکل برطرف شد .

معماری غیرمسدودکننده

در نسخه اولیه برنامه، استفاده از delay باعث توقف اجراي حلقه اصلی و در نتیجه اختالل در عملکرد 30100MAXمیشد. این موضوع منجر به نمایش مقادیر صفر براي BPM و ₂SpO در هنگام فعال بودن وبسرور می گردید .

در نسخه نهایی، تمامیdelay هاي طوالنی حذف شدند و مدیریت زمان با استفاده از millis انجام شد. براي هر سنسور یک بازه زمانی مستقل تعریف شد و اجراي آن ها به صورت شرطی و غیرمسدودکننده انجام می گیرد. تابع update مربوط به 30100MAX در هر تکرار حلقه loop فراخوانی میشود تا الگوریتم داخلی آن بدون وقفه اجرا گردد.

این بازطراحی یکی از مهم ترین نقاط عطف پروژه محسوب می شود و موجب پایداري کامل خواندن داده ها در حضور Fi-Wi و وب سرور شد .

-4-4پیادهسازی سیستم هشدار و منطق تصمیمگیری
پس از تثبیت خواندن داده ها، مرحله پیاده سازي منطق هشدار آغاز شد. براي هر پارامتر بازههاي نرمال، هشدار و بحرانی تعریف گردید. این بازه ها بر اساس مقادیر فیزیولوژیک عمومی انتخاب شدند .

براي جلوگیري از هشدارهاي کاذب، شرط تغییر وضعیت تنها در صورتی فعال می شود که مقدار خارج از محدوده براي چند نمونه متوالی تکرار گردد. به عنوان مثال، اگر BPM به طور لحظه اي از حد تعریف شده عبور کند ولی در نمونه بعدي به محدوده طبیعی بازگردد، وضعیت سیستم تغییر نمی کند .

عالوه بر این، یک سطح جداگانه براي Fault Sensor در نظر گرفته شد. در صورتی که داده اي نامعتبر باشد ) مانند قطع تماس سنسور PPG یا عدم پاسخ(20B18DS ، وضعیت مربوطه به خطا تغییر می کند و از نمایش داده قدیمی جلوگیري می شود.

وضعیت کلی سیستم بر اساس شدیدترین وضعیت فعال تعیین می شود و در باالي داشبورد نمایش داده می شود.

-4-5پیادهسازی رابط کاربری تحت وب
رابط کاربري به صورت یک صفحه HTML پویا تولید می شود که توسط تابع SendHTML ساخته شده و به درخواست کاربر ارسال می گردد. داده هاي سنسورها هر یک ثانیه به روزرسانی می شوند .

طراحی داشبورد بر اساس سادگی، خوانایی و نمایش واضح وضعیت ها انجام شده است. براي هر پارامتر یک کارت جداگانه با مقدار عددي و واحد مربوطه در نظر گرفته شده است. رنگ بندي کارتها متناسب با وضعیت پارامتر تغییر می کند .

در باالي صفحه، یک نوار وضعیت کلی سیستم قرار دارد که می تواند در یکی از حالتهاي زیر باشد :

- OK( سبز( • Warning( زرد(
) | بنفش )Sensor Fault | • | )قرمز )Critical | •

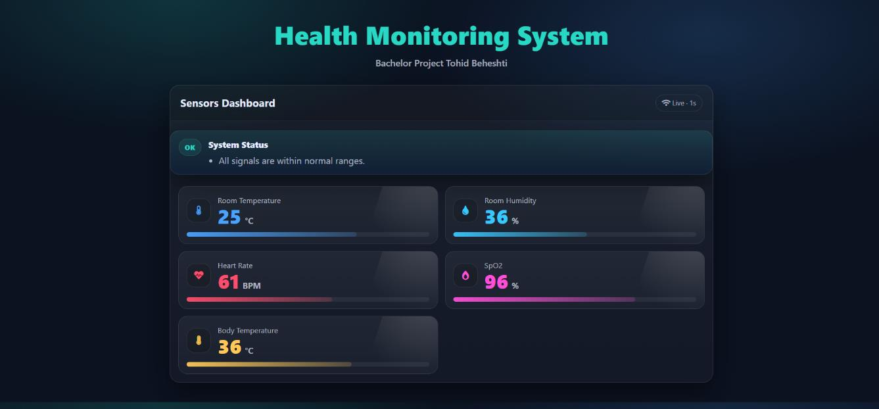
[picture p13: figure]

شکل.8 نماي داشبورد در وضعیت عادي(OK(

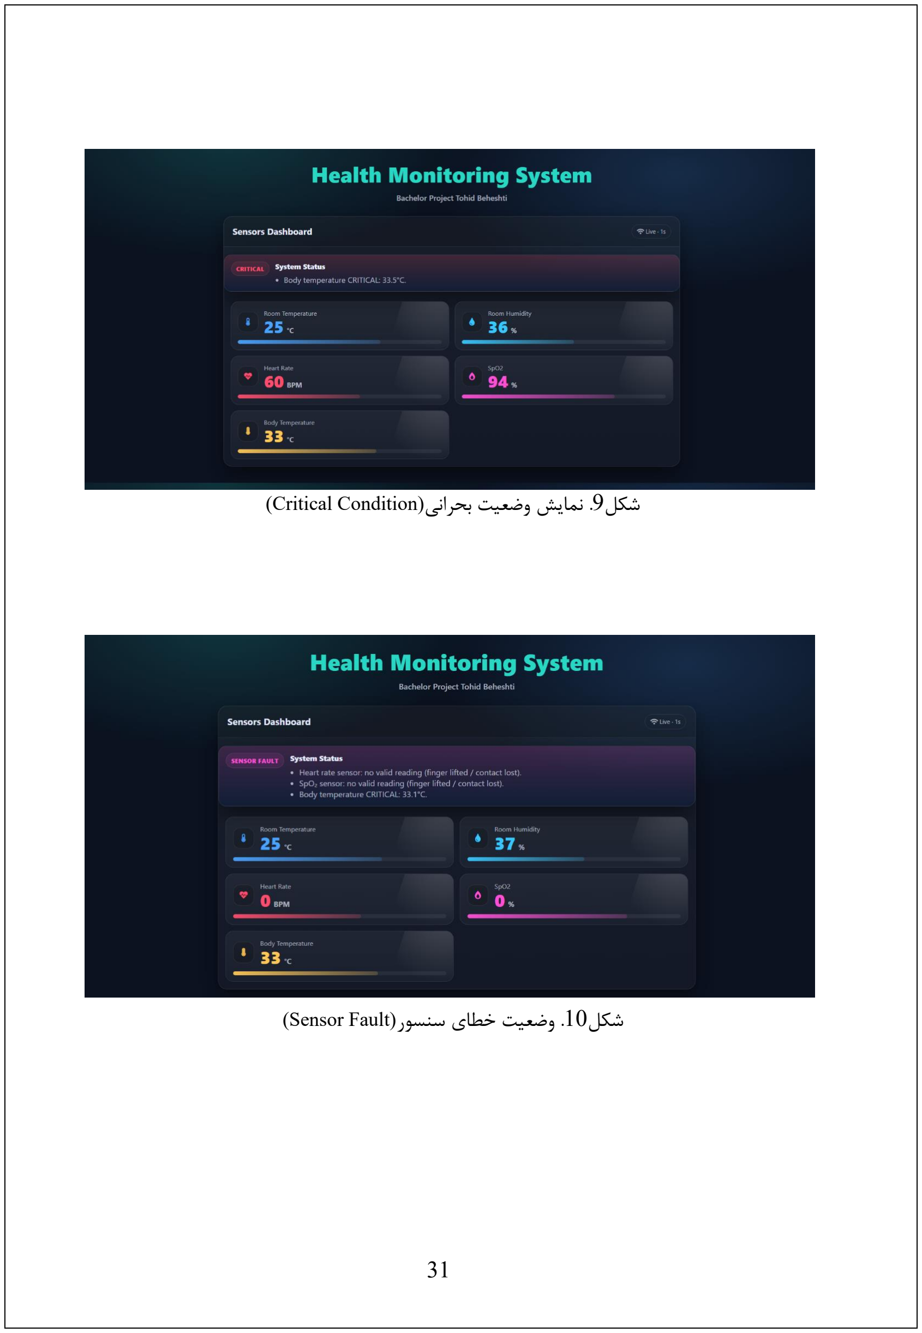
[picture p14: page 31]

شکل.9 نمایش وضعیت بحرانی(Condition Critical(

شکل.10 وضعیت خطاي سنسور(Fault Sensor(

-4-6 اجرای سناریوهای آزمون و بررسی عملکرد سیستم
پس از تکمیل پیاده سازي سختافزار و نرم افزار، سامانه در مجموعه اي از سناریوهاي عملی مورد آزمون قرار گرفت تا رفتار آن در شرایط واقعی ارزیابی شود. این آزمون ها با هدف بررسی پایداري، صحت نسبی داده ها، عملکرد سیستم هشدار و واکنش سامانه در شرایط غیرعادي طراحی شدند .

در نخستین سناریو، سیستم در حالت استراحت کامل کاربر مورد بررسی قرار گرفت. در این وضعیت، ضربان قلب در بازه 70 تا 90 ضربه در دقیقه ثبت شد و سطح اکسیژن خون بین 95 تا 99 درصد باقی ماند. دماي بدن در محدوده 36.2 تا 36.8 درجه سانتیگراد اندازه گیري شد که با مقادیر فیزیولوژیک طبیعی همخوانی دارد. در این حالت، داشبورد وضعیت کلی سیستم را در سطح OK نمایش داد و رنگبندي عناصر گرافیکی نیز در حالت پایدار باقی ماند .

در سناریوي دوم، پس از انجام فعالیت بدنی سبک مانند راه رفتن سریع به مدت یک دقیقه، افزایش تدریجی مقدار BPM مشاهده شد که در برخی نمونه ها به محدوده 100 تا 110 رسید. پس از توقف فعالیت، کاهش تدریجی ضربان قلب و بازگشت آن به محدوده طبیعی ثبت گردید. این رفتار دینامیکی نشان می دهد که سیستم قادر به ثبت تغییرات واقعی فیزیولوژیک با تأخیر قابل قبول است. در صورتی که مقدار ضربان از آستانه تعریفشده عبور می کرد و این وضعیت براي چند نمونه متوالی پایدار می ماند، سطح هشدار به Warning یا Critical تغییر می یافت و نوار وضعیت در باالي داشبورد نیز رنگ مربوطه را نمایش می داد.

در سناریوي سوم، تماس انگشت با سنسور 30100MAX قطع شد. در نسخه هاي اولیه سیستم، مقادیر قبلی براي مدتی بدون تغییر باقی می ماندند که می توانست گمراه کننده باشد. در نسخه نهایی، پس از گذشت زمان تعیین شده بدون ثبت ضربان جدید، سیستم وضعیت Fault Sensor را فعال کرد و مقادیر BPMو ₂SpO به حالت نامعتبر منتقل شدند. این رفتار نشان می دهد که الگوریتم تشخیص عدم تماس به درستی عمل می کند و از نمایش داده هاي قدیمی جلوگیري می شود.

سناریوي دیگر شامل قطع موقت سنسور دماي بدن یا ایجاد خطا در اتصال آن بود. در این حالت، مقدار C-127° درجه که نشانه عدم شناسایی سنسور است دریافت شد و سیستم بالفاصله وضعیت خطا را براي آن پارامتر فعال کرد. این واکنش نشان می دهد که مدیریت خطا به صورت سیستماتیک در نرم افزار لحاظ شده و سیستم در مواجهه با نقص سخت افزاري رفتار پیشبینی پذیر دارد.

-4-7 ارزیابی پایداری در کار مداوم
یکی از آزمون هاي مهم، بررسی عملکرد سامانه در بازه زمانی طوالنی بود. سیستم براي چندین ساعت به صورت پیوسته روشن نگه داشته شد و داده ها به طور مداوم در داشبورد تحت وب نمایش داده شدند. در نسخه هاي اولیه، پس از مدتی اجراي هم زمان Fi-Wi و سنسورها باعث بروز اختالل در خواندن داده هاي 30100MAXمیشد. با بازطراحی معماري نرم افزار و حذف کامل توابع مسدودکننده، این مشکل به طور کامل برطرف گردید .

در آزمون نهایی، هیچ گونه قطع ارتباط Fi-Wi یا افت محسوس در نرخ به روزرسانی مشاهده نشد. اجراي پیوسته تابع update در حلقه اصلی و تفکیک زمان بندي سنسورها موجب شد سیستم حتی در شرایط بار پردازشی هم زمان، پایداري خود را حفظ کند. این نتیجه نشان می دهد که معماري غیرمسدودکننده انتخابشده در فصل طراحی، در مرحله اجرا نیز عملکرد مؤثري داشته است. همچنین در دوره اي که دسترسی به اینترنت سراسري محدود بود، سامانه صرفاً در شبکه محلی مورد استفاده قرار گرفت. در این حالت نیز بدون نیاز به سرویس هاي ابري، داده ها در داشبورد نمایش داده شدند. این تجربه عملی، مزیت معماري مبتنی بر وب سرور داخلی را تأیید کرد و نشان داد که سیستم در شرایط واقعی بهره برداري انعطافپذیر است.

-4-8تحلیل رفتار سیستم و محدودیتهای نسخه فعلی
تحلیل عملکرد سامانه نشان می دهد که ترکیب پردازش سیگنال اولیه، مدیریت زمان بندي و سیستم هشدار چندسطحی موجب افزایش قابل توجه قابلیت اطمینان سیستم شده است. حذف جهش هاي ناگهانی و استفاده از میانگین نمایی باعث کاهش نویز در مقادیر BPM و ₂SpO گردید، در حالی که الگوریتم تشخیص قطع تماس از نمایش داده هاي غیرواقعی جلوگیري کرد.

با این حال، محدودیت هایی نیز در نسخه فعلی وجود دارد. نخست آنکه سیگنال PPG همچنان به حرکت دست حساس است و در صورت لرزش شدید، ممکن است براي مدت کوتاهی نوسانات غیرعادي مشاهده شود. دوم آنکه داده ها در حال حاضر ذخیره سازي بلندمدت ندارند و تحلیل تنها به سطح لحظه اي محدود است. همچنین سیستم هشدار تنها در سطح نمایش بصري عمل می کند و خروجی فیزیکی مانند Buzzerدر این نسخه فعال نشده است.

این محدودیتها نشان می دهند که اگرچه سامانه به یک سطح عملکرد پایدار رسیده است، اما همچنان ظرفیت توسعه در نسخه هاي آینده وجود دارد.

-4-9جمع بندی فصل پیادهسازی
فصل حاضر نشان داد که پیادهسازي عملی یک سامانه پایش سالمت مبتنی بر IOT نیازمند توجه همزمان به جزئیات سختافزاري و معماري نرم افزاري است. بسیاري از مشکالت مشاهدهشده در مراحل اولیه، نه ناشی از انتخاب نامناسب سنسورها، بلکه ناشی از ساختار زمانبندي و مدیریت نادرست منابع بودند. بازطراحی حلقه اصلی برنامه و حذف توابع مسدودکننده نقش کلیدي در رسیدن به نسخه پایدار ایفا کرد.

نسخه نهایی سامانه توانست عالئم حیاتی را با پایداري مناسب ثبت و در شرایط ناهنجار واکنش منطقی و قابل پیشبینی نشان دهد. پیاده سازي سیستم هشدار چندسطحی و طراحی داشبورد واکنش گرا، سامانه را از یک نمونه ساده نمایش داده به یک ابزار پایش فعال ارتقا داد.

در مجموع، مرحله پیاده سازي نشان داد که فرآیند مهندسی در سیستم هاي نهفته یک مسیر تدریجی مبتنی بر آزمون، تحلیل و اصالح است و رسیدن به عملکرد قابل اتکا نتیجه مجموعه اي از بهبودهاي مرحله اي بوده است.

## فصل پنجم: نتیجهگ یری و پشینهادهای توسعه آینده

-5-1 نتیجهگیری
در این پژوهش، طراحی و پیاده سازي یک سامانه پوشیدنی مبتنی بر اینترنت اشیاء براي پایش بالدرنگ عالئم حیاتی انجام شد. هدف اصلی پروژه، توسعه سیستمی کم هزینه، مستقل از زیرساختهاي ابري و در عین حال پایدار و قابل اعتماد بود که بتواند چندین پارامتر زیستی و محیطی را به صورت هم زمان اندازهگیري و تحلیل کند .

نتایج حاصل از پیاده سازي نشان داد که ترکیب میکروکنترلر 32ESP با سنسورهاي30100MAX ، 20B18DSو 11DHT می تواند بستري مناسب براي ساخت یک سامانه پایش سالمت فراهم آورد. سیستم طراحیشده قادر است ضربان قلب، سطح اکسیژن خون، دماي بدن و شرایط محیطی را با پایداري قابل قبول ثبت کرده و در یک داشبورد تحت وب به صورت بالدرنگ نمایش دهد .

یکی از مهم ترین دستاوردهاي این پروژه، بازطراحی معماري نرم افزار به صورت غیرمسدودکننده بود. تجربه عملی نشان داد که استفاده از ساختارهاي مبتنی بر delay در سیستمهاي بالدرنگ منجر به اختالل در عملکرد سنسورهاي حساس به زمان، به ویژه30100MAX ، می شود. با حذف کامل توابع مسدودکننده و استفاده از زمانبندي مبتنی برmillis ، پایداري سیستم به طور چشمگیري افزایش یافت. این تغییر نشان داد که در سیستمهاي نهفته، کیفیت معماري نرم افزار به اندازه انتخاب سختافزار اهمیت دارد.

افزون بر این، پیاده سازي الگوریتم هاي پردازش سیگنال شامل حذف جهش هاي ناگهانی، فیلتر میانگین نمایی و مکانیزم تشخیص قطع تماس انگشت، باعث شد خروجی سیستم رفتار طبیعی تر و قابل اعتمادتري داشته باشد. افزودن سیستم هشدار چندسطحی نیز سامانه را از یک نمایشگر ساده داده به یک ابزار پایش فعال ارتقا داد که قادر است خروج از محدوده هاي تعریف شده را تشخیص داده و بازخورد مناسب ارائه دهد .

در بعد سخت افزاري، تجربه خطاهایی نظیر عدم استفاده از مقاومت up-Pull براي 20B18DS یا مقداردهی اولیه نادرست سنسورها نشان داد که توجه به جزئیات کوچک در طراحی، نقش تعیینکننده اي در عملکرد کلی سیستم دارد. این تجربه عملی، اهمیت فرآیند آزمون و خطا و تحلیل علت ریشه اي مشکالت را در پروژه هاي مهندسی برجسته می کند .

به طور کلی، سامانه توسعه یافته توانست اهداف اصلی تحقیق را محقق سازد و به عنوان یک نمونه عملی از یک سیستم پایش سالمت مبتنی بر IoT عمل کند. هرچند این سامانه در سطح یک محصول تجاري نیست، اما به عنوان یک پلتفرم آموزشی و تحقیقاتی، قابلیت توسعه و ارتقاي قابل توجهی دارد.

-5-2 پیشنهادهای توسعه آینده
با وجود موفقیت نسخه فعلی سامانه، زمینه هاي متعددي براي توسعه و بهبود آن وجود دارد. نخستین مسیر توسعه می تواند افزودن قابلیت ذخیره سازي داده ها در حافظه محلی یا ارسال آن ها به یک پایگاه داده ابري باشد. ذخیره سازي بلندمدت داده ها امکان تحلیل روند تغییرات و استخراج الگوهاي سالمت را فراهم می کند که براي کاربردهاي پزشکی ارزشمند است.

مسیر دیگر، توسعه الگوریتم هاي تحلیل پیشرفته تر است. استفاده از روش هاي پردازش سیگنال پیشرفته یا حتی الگوریتم هاي یادگیري ماشین می تواند دقت تشخیص ناهنجاري ها را افزایش دهد و سیستم را از یک سامانه آستانه محور به یک سامانه تحلیل گر هوشمند ارتقا دهد .

بهبود طراحی سختافزار و تبدیل نمونه بردبوردي به یک برد مدار چاپی (PCB (اختصاصی نیز می تواند موجب کاهش نویز، افزایش پایداري و کوچک تر شدن ابعاد سامانه شود. این اقدام گامی مهم در جهت تبدیل پروژه به یک محصول قابل استفاده روزمره خواهد بود.

افزودن ماژول هاي تکمیلی مانند سنسورECG ، فشار خون یا شتابسنج نیز می تواند دامنه پایش را گسترش دهد و تصویر جامع تري از وضعیت فیزیولوژیک کاربر ارائه کند. همچنین افزودن یک سیستم هشدار فیزیکی مانند Buzzer یا اعالن موبایلی می تواند واکنش سیستم را از سطح نمایش بصري فراتر ببرد.

در نهایت، طراحی یک اپلیکیشن موبایل اختصاصی براي ارتباط مستقیم با 32ESP و نمایش داده ها در قالب گراف هاي زمانی می تواند تجربه کاربري را بهبود دهد و سامانه را به یک پلتفرم کاملتر پایش سالمت تبدیل کند .

-5-3جمع بندی نهایی
پروژه حاضر نشان داد که طراحی یک سامانه پایش سالمت مبتنی بر اینترنت اشیاء، فرآیندي چندبعدي است که نیازمند درك هم زمان از سخت افزار، نرم افزار، پردازش سیگنال و تعامل کاربر با سیستم است. موفقیت نهایی این پروژه نه حاصل یک تصمیم واحد، بلکه نتیجه مجموعه اي از اصالحات تدریجی و تحلیل دقیق مشکالت بوده است.

تجربه حاصل از این تحقیق بیانگر آن است که حتی در پروژه هاي کوچک مقیاس، رعایت اصول معماري نرم افزار، مدیریت زمان بندي و توجه به جزئیات سخت افزاري می تواند تفاوت میان یک سیستم ناپایدار و یک سامانه قابل اعتماد را رقم بزند. این پروژه عالوه بر دستیابی به اهداف فنی خود، زمینه اي براي توسعه هاي آینده و پژوهش هاي پیشرفته تر در حوزه پایش سالمت هوشمند فراهم کرده است.

## مراجع

1. Datasheet of MAX30102 Pulse Oximeter and Heart-Rate Sensor, Maxim Integrated, 2023.
2. ESP32 Technical Reference Manual, Espressif Systems, 2023.
3. Analog Devices (Maxim Integrated) – MAX30100 Pulse Oximeter and Heart-Rate Sensor IC Datasheet
4. DS18B20 – Digital Temperature Sensor Datasheet
5. DHT11 – Temperature & Humidity Sensor _ Technical specification Manual
6. M. M. Rahman, M. A. Qureshi and M. Z. U. Khan, “A Review on Smart Health Monitoring Systems using IoT,” Health Information Science and Systems, vol. 9, no. 1, pp. 1– 15, 2021.
7. L. Atzori, A. Iera and G. Morabito, “The Internet of Things: A Survey on Enabling Technologies, Protocols, and Applications,” IEEE Communications Surveys & Tutorials, vol. 17, no. 4, pp. 2347-2376, 2015.

## پیوست ها

پیوست-1 جدول آستانههای سیستم هشدار

محدوده نرمال

(OK)

محدوده هشدار

(Warning)

محدوده بحرانی(Critical(

وضعیت خطاي سنسور Sensor(

Fault)

پارامتر

ضربان قلب(BPM (مقدار صفر یا عدم تشخیص ضربان کمتر از 50 یا بیشتر از 120 59 – 50یا 101 – 120 bpm 100 – 60

| مقدار صفر یا قطع تماس انگشت کمتر از %90 94% – 90% 95% ≤ | سطح اکسیژن خون (SpO₂)
36.0 – 37.4 | 37.5 – 37.9 | کمتر از 35.0 یا بیشتر از 38.0 | مقدار 127- یا 85 درجه )خطاي سنسور( | دماي بدن(C°(

دماي محیط(C° (مقدار غیرواقعی یا عدم پاسخ کمتر از 18 یا بیشتر از 30 19 – 18یا 27 – 30 26 – 20

رطوبت محیط(%) مقدار خارج از بازه 0– %100 کمتر از 20 یا بیشتر از 70 29 – 20یا 61 – 70 60 – 30

پیوست-2 جدول اتصاالت ماژولها به32ESP( Assignment pin)

ماژول پایه ماژول پایه متصل به32ESP توضیحات

I2C ارتباط | GPIO21 | SDA | MAX30100
I2C ارتباط | GPIO22 | SCL | MAX30100
(Interrupt)وقفه | GPIO19 | INT | MAX30100
تغذیه | 3.3V | VCC | MAX30100
مشترك زمین | GND | GND | MAX30100
تغذیه | 3.3V | VCC | DS18B20
مشترك زمین | GND | GND | DS18B20
Pull-up 4.7kΩ مقاومت داراي | GPIO5 | Signal (DQ) | DS18B20
تغذیه | 3.3V | VCC | DHT22
مشترك زمین | GND | GND | DHT22

22DHT Signal 18GPIO ارتباط دیجیتال تک سیمه

پیوست-3 دسترسی به کد پروژه

جهت مستندسازي کامل و فراهمسازي امکان بازتولید سامانه، نسخه نهایی کد پروژه در GitHub منتشر شده است. آخرین نسخه پایدار سیستم از طریق لینک زیر قابل دسترسی می باشد :

https://github.com/TohidBeh/Health-Monitoring-System.git
