TohidBeh/Health-Monitoring-System/Images/fault.png

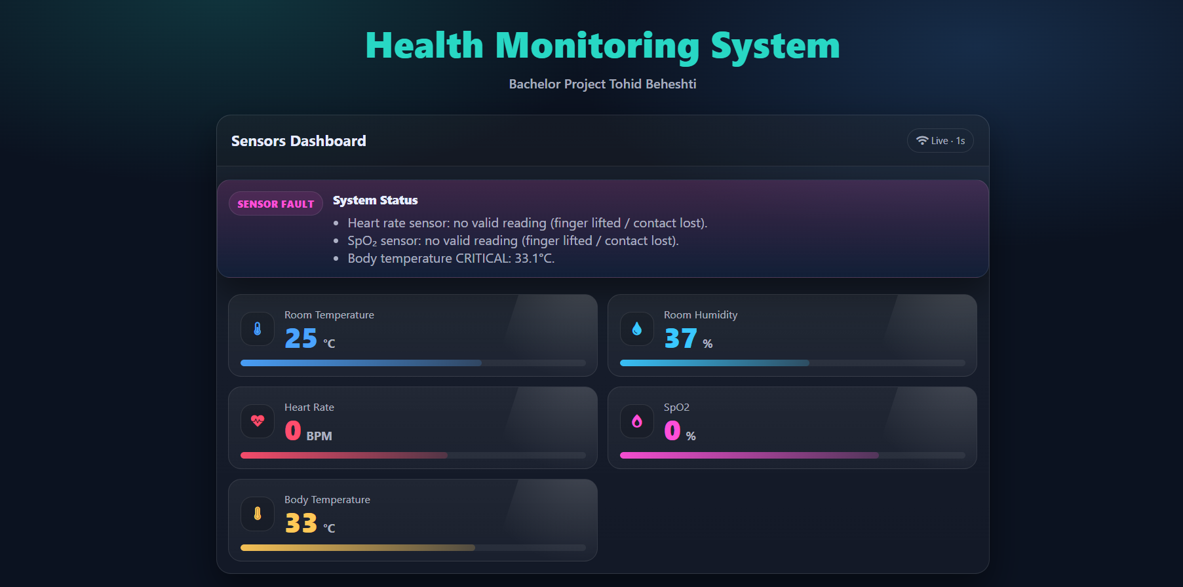
Images/fault.png
